alexlutsenko7/Nimbus_private/Book/Graphics/70ac2a42-c404-4ae4-8e17-2ef2ec8157f1.png

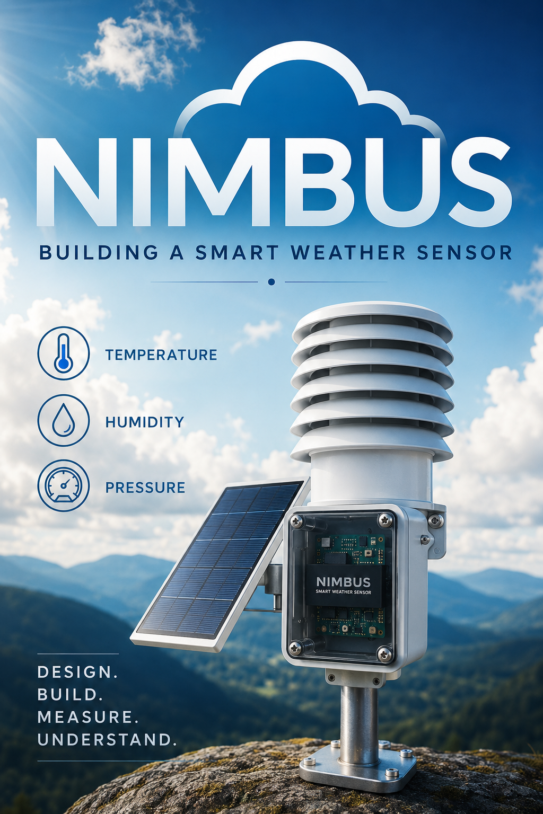
Book/Graphics/70ac2a42-c404-4ae4-8e17-2ef2ec8157f1.png
