alexlutsenko7/Nimbus_private/Book/Graphics/5ab63f9f-29ac-4de8-b75b-256e70acc06c.png

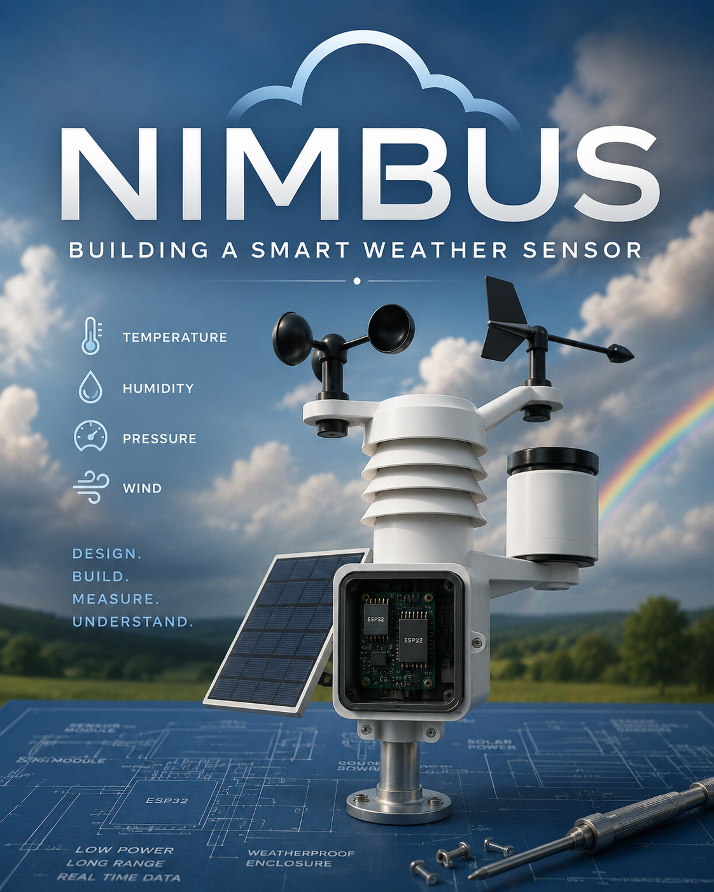
Book/Graphics/5ab63f9f-29ac-4de8-b75b-256e70acc06c.png
