alexlutsenko7/Nimbus_private/Book/Presentation_block_diagram.pptx

XIAO ESP32
Wi-Fi/BT

Antenna

BME280
Environment

Feedback

I2C

STM32L031
CPU eval board

USB to a PC

Pwr

UART

BME280
Environment

Pwr

I2C

STM32L031
CPU eval board

USB to a PC

Antenna

Bridge

BME280
Environment

Battery

Pwr

XIAO ESP32
Wi-Fi/BT

I2C

STM32L031
CPU eval board

Feedback

UART
