alexlutsenko7/Nimbus_private/android/ChangePass.jpg

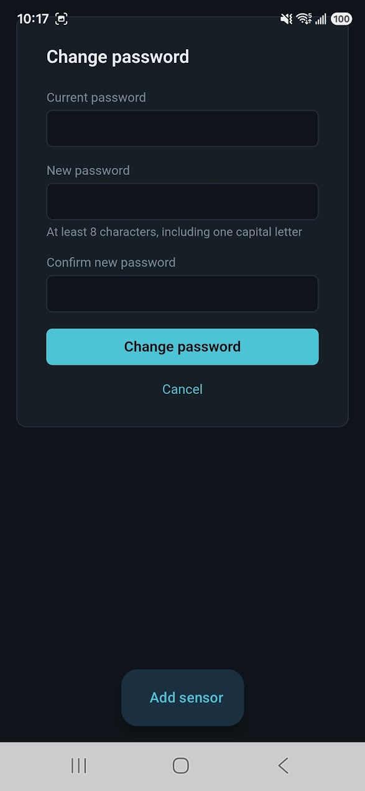
android/ChangePass.jpg
