alexlutsenko7/Nimbus_private/android/CreateAccount.jpg

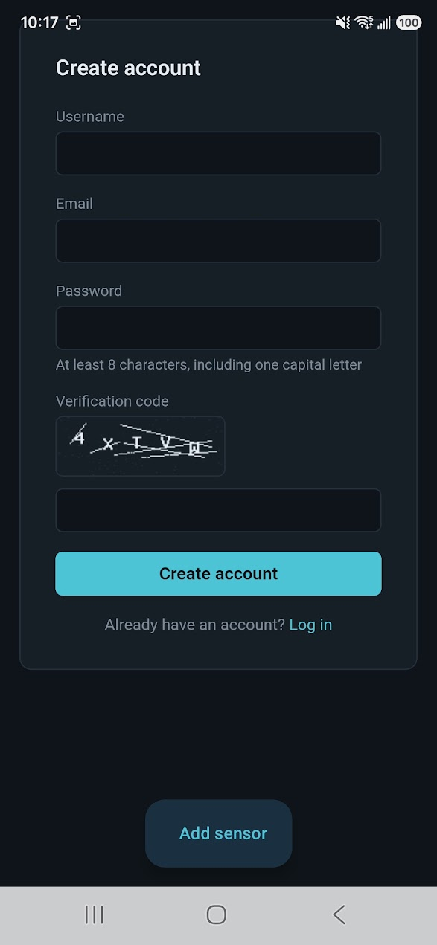
android/CreateAccount.jpg
