alexlutsenko7/Nimbus_private/android/Login.jpg

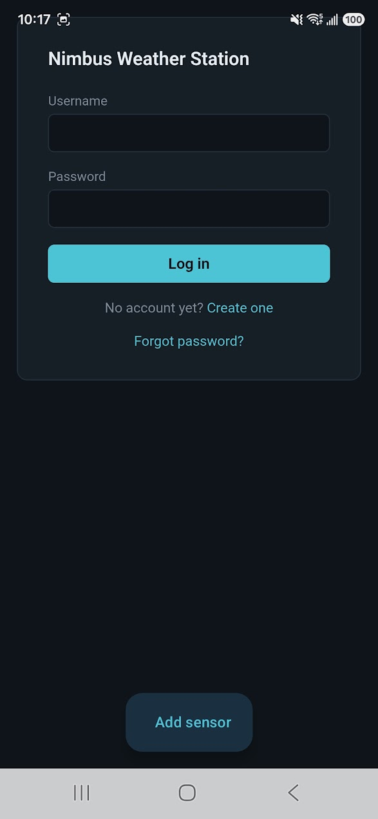
android/Login.jpg
