alexlutsenko7/Nimbus_private/android/MainScreeshot.jpg

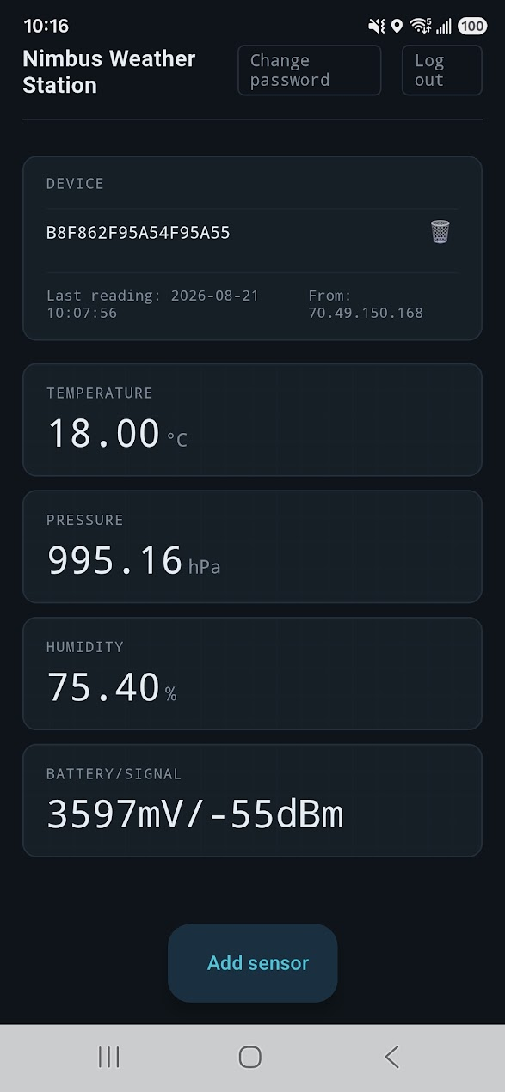
android/MainScreeshot.jpg
