alexlutsenko7/Nimbus_private/android/title_screen_pc.jpg

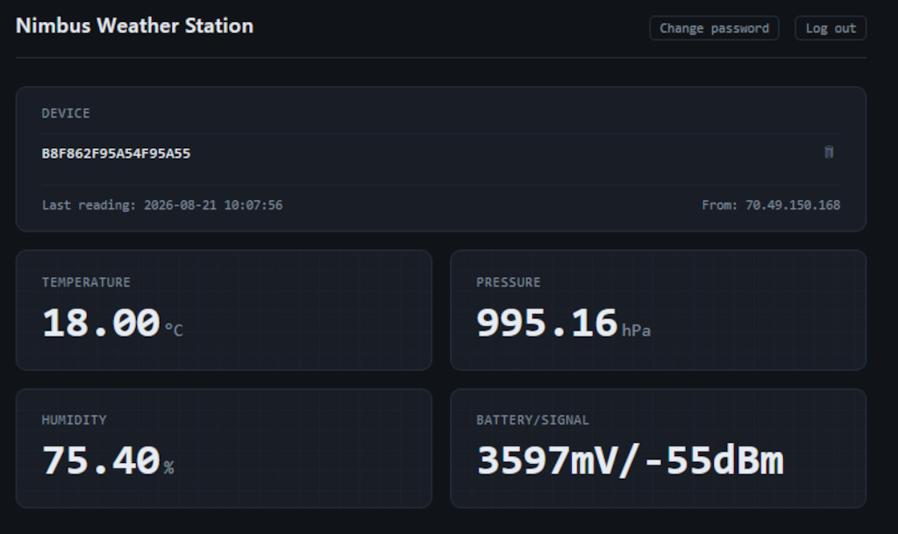
android/title_screen_pc.jpg
