alexlutsenko7/Nimbus_private/Sch_pcb/Nimbus-BOM_JLCSMT.xlsx

Comment | Designator | Footprint | JLCPCB Part #（optional）
100nF | C1, C2, C4, C5, C7, C9, C12 | C_0603_1608Metric | C1591
100uF | C6, C8, C11 | C_1206_3216Metric | C312983
22uF | C3 | C_0603_1608Metric | C84419
1000uF | C10 | CAP_10 | C43339
100k | R3, R4, R7 | R_0603_1608Metric | C14675
4k7 | R5, R6 | R_0603_1608Metric | C25999
470 | R1 | R_0603_1608Metric | C177286
1M | R2 | R_0603_1608Metric | C177344
Ferrite Bead 0805 | L1 | L_0805 | C85840
LED NCD0603R1 | D1 | D_0603_1608Metric | C84263
TPS22917DBV | U3 | SOT-23-6 | C2680344
STM32L031K6T6TR | U1 | LQFP-32(7x7) | C94085
BME280 | U2 | LGA-8(2.5x2.5) | C92489
AO3401A | Q1 | SOT-23 | C15127
