alexlutsenko7/Nimbus_private/Sch_pcb/Sample-BOM_JLCSMT.xlsx

Comment | Designator | Footprint | JLCPCB Part #（optional）
100uF | C1 | CAP-SMD_L3.5-W2.8 | C16133
15K | R5,R6 | R0603 | C22809
DC-005-20A_C136744 | DC1 | DC-IN-TH_DC-005-20A | C136744
Header-Female-2.54_1x8 | P2,P3 | HDR-TH_8P-P2.54-V | C27438
K2-1102DP-C4SW-04 | SW1 | KEY-TH_4P-L6.0-W6.0-P4.50-LS6.5 | C110153
ATMEGA328P-PU | U1 | DIP-28_L34.6-W7.3-P2.54-LS10.2-BL | C33901
670688000 | USB1 | USB-B-TH_67068-8000 | C114097
