alexlutsenko7/Nimbus_private/Book/Graphics/Pict1Nimbus_components.png

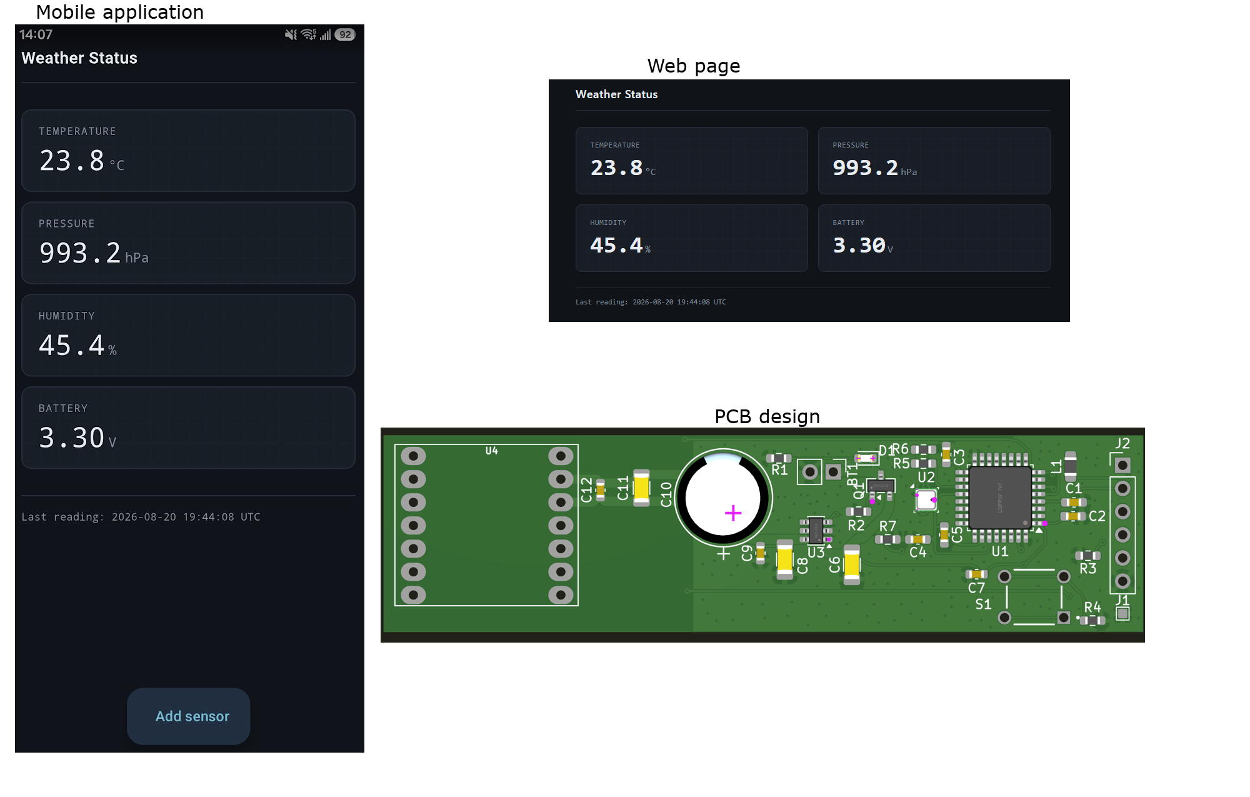
Book/Graphics/Pict1Nimbus_components.png
