alexlutsenko7/Nimbus_private/Sch_pcb/Nimbus.kicad_pcb

## KiCad design Sch_pcb/Nimbus.kicad_pcb (2026-08-18)

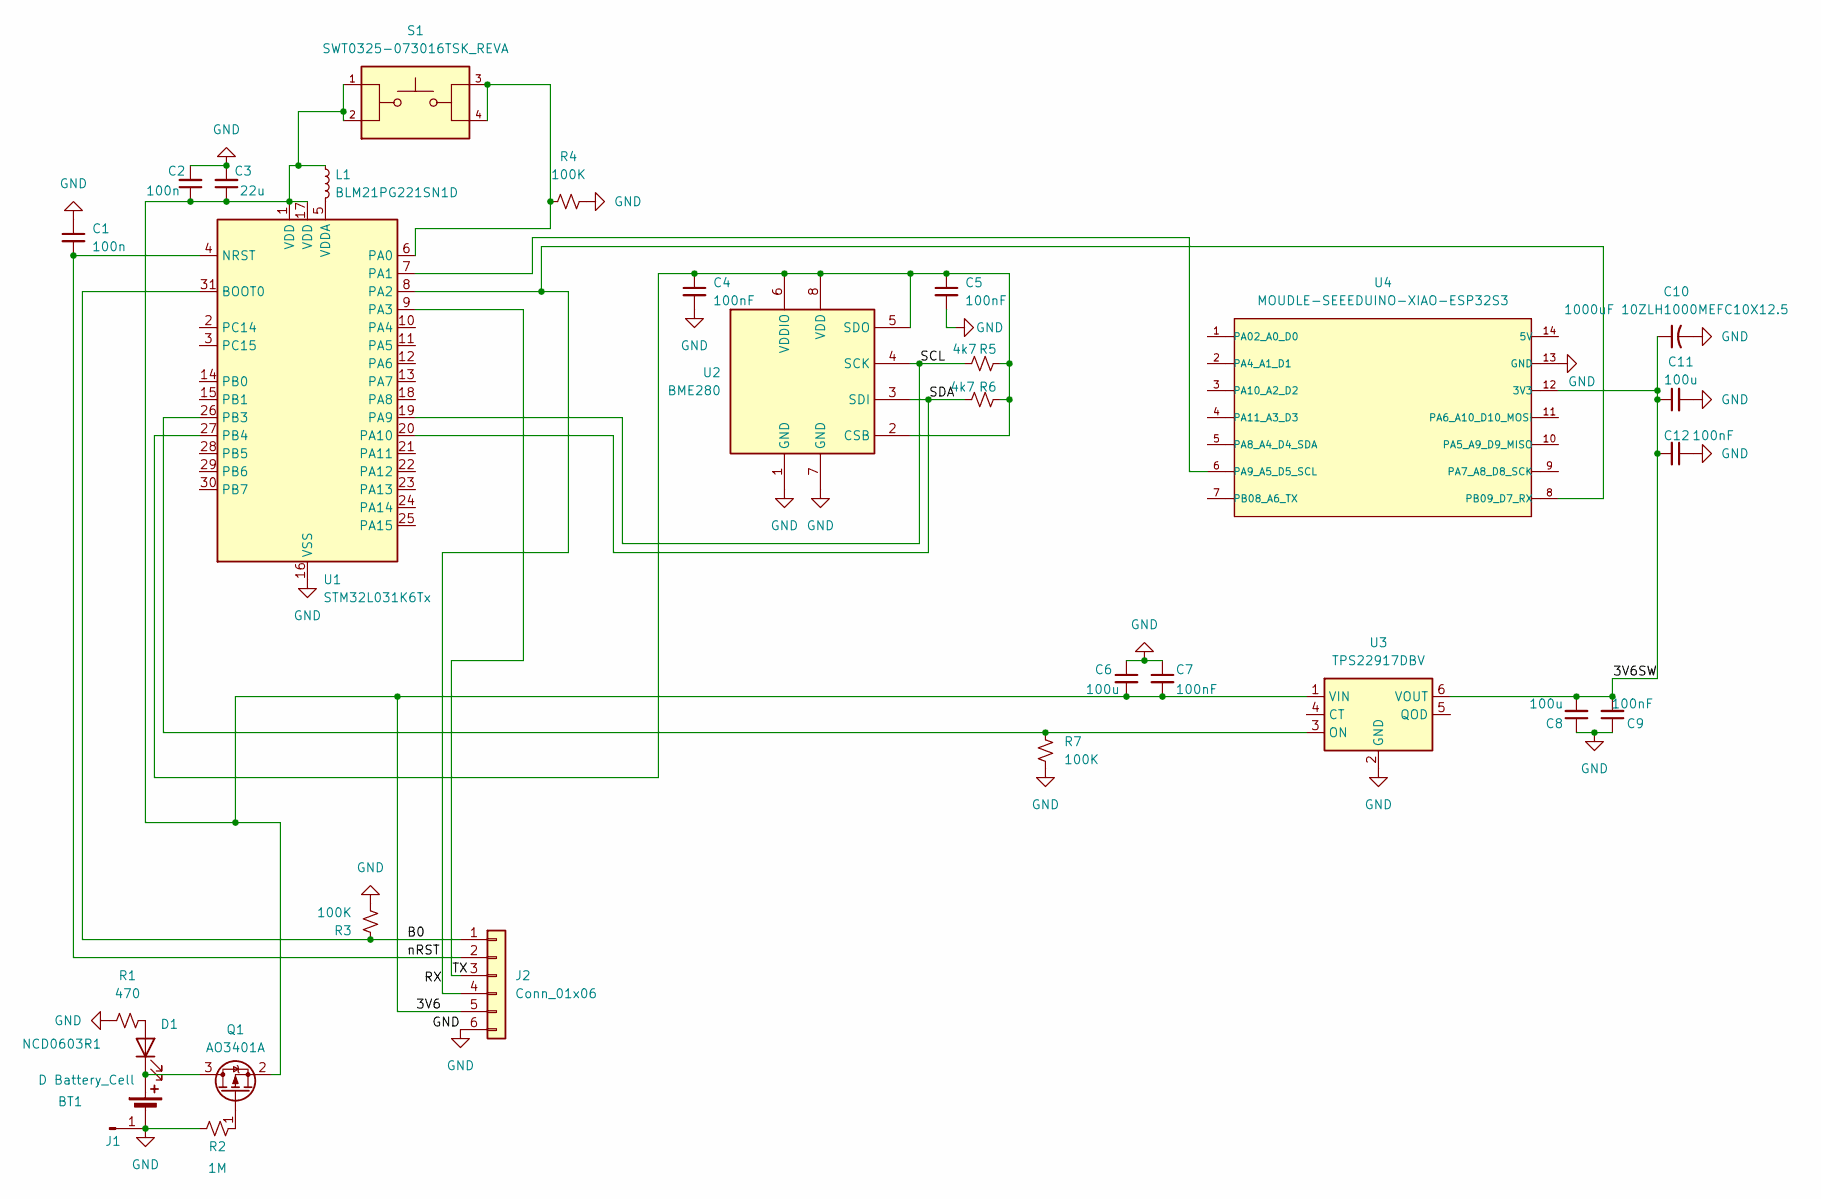
[picture p9: schematic Nimbus.kicad_sch]

Parts:
BT1: D Battery_Cell; PinHeader_1x02_P2.54mm_Vertical
C1, C2: 100n; C_0603_1608Metric_Pad1.08x0.95mm_HandSolder
C3: 22u; C_0603_1608Metric_Pad1.08x0.95mm_HandSolder
C4, C5: 100nF; C_0603_1608Metric_Pad1.08x0.95mm_HandSolder
C6, C8: 100u; C_1206_3216Metric_Pad1.33x1.80mm_HandSolder
C7, C9, C12: 100nF; C_0603_1608Metric
C10: 1000uF 10ZLH1000MEFC10X12.5; CAP_10X12.5_RUB
C11: 100u; C_1206_3216Metric
D1: NCD0603R1; D_0603_1608Metric
J1: GND; TestPoint_Pad_1.0x1.0mm
J2: Conn_01x06; PinHeader_1x06_P2.54mm_Vertical
L1: BLM21PG221SN1D; L_0805_2012Metric_Pad1.05x1.20mm_HandSolder
Q1: AO3401A; SOT-23
R1: 470; R_0603_1608Metric_Pad0.98x0.95mm_HandSolder
R2: 1M; R_0603_1608Metric_Pad0.98x0.95mm_HandSolder
R3, R4, R7: 100K; R_0603_1608Metric_Pad0.98x0.95mm_HandSolder
R5, R6: 4k7; R_0603_1608Metric_Pad0.98x0.95mm_HandSolder
S1: SWT0325-073016TSK_REVA; SW_SWT0325-073016TSK_REVA; PARTREV A
U1: STM32L031K6Tx; LQFP-32_7x7mm_P0.8mm
U2: BME280; Bosch_LGA-8_2.5x2.5mm_P0.65mm_ClockwisePinNumbering
U3: TPS22917DBV; SOT-23-6
U4: MOUDLE-SEEEDUINO-XIAO-ESP32S3; AlxXIAO_MOUDLE14P-SMD-2.54-21X17.8MM

Connections:
/3V6: C2.1, C3.1, C6.2, C7.2, J2.5, L1.1, Q1.2 (S), S1.1, S1.2, U1.1 (VDD), U1.17 (VDD), U3.1 (VIN)
/3V6SW: C8.2, C9.2, C10.1, C11.1, C12.2, U3.6 (VOUT), U4.12 (3V3)
/B0: J2.1, R3.1, U1.31 (BOOT0)
/RX: J2.4, U1.8 (PA2), U4.8 (PB09_D7_RX)
/SCL: R5.1, U1.19 (PA9), U2.4 (SCK)
/SDA: R6.1, U1.20 (PA10), U2.3 (SDI)
/TX: J2.3, U1.9 (PA3)
/nRST: C1.2, J2.2, U1.4 (NRST)
GND: BT1.2 (-), C1.1, C2.2, C3.2, C4.2, C5.2, C6.1, C7.1, C8.1, C9.1, C10.2, C11.2, C12.1, J1.1 (Pin_1_1), J2.6, R1.1, R2.1, R3.2, R4.2, R7.2, U1.16 (VSS), U1.32 (VSS), U2.1 (GND), U2.7 (GND), U3.2 (GND), U4.13 (GND)
unnamed: BT1.1 (+), D1.1 (K), Q1.3 (D)
unnamed: D1.2 (A), R1.2
unnamed: Q1.1 (G), R2.2
unnamed: R4.1, S1.3, S1.4, U1.6 (PA0)
unnamed: U1.7 (PA1), U4.6 (PA9_A5_D5_SCL)
unnamed: R7.1, U1.26 (PB3), U3.3 (ON)
unnamed: C4.1, C5.1, R5.2, R6.2, U1.27 (PB4), U2.2 (CSB), U2.5 (SDO), U2.6 (VDDIO), U2.8 (VDD)
unnamed: L1.2, U1.5 (VDDA)

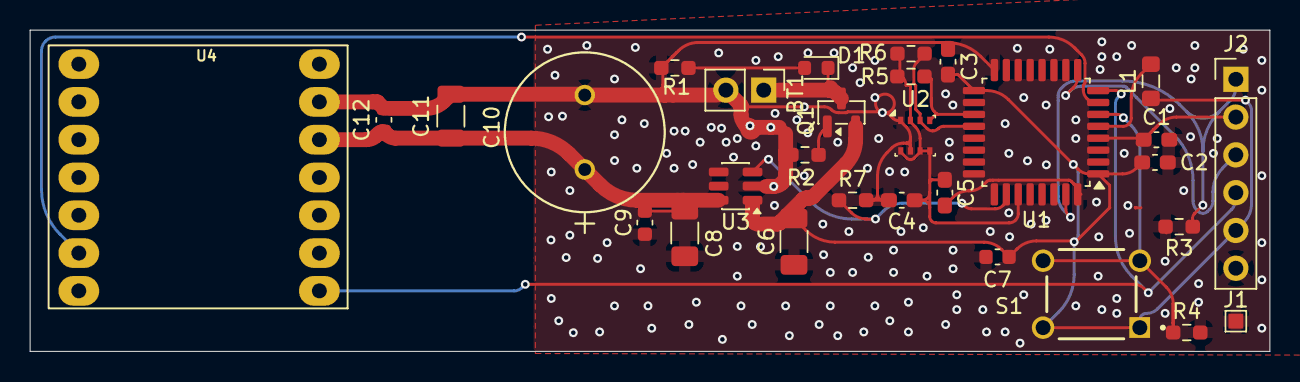
[picture p10: board Nimbus.kicad_pcb from above]

Board: 2 copper layers, 83.3 x 21.6 mm, 30 parts (0 on the bottom side), 17 nets.
