alexlutsenko7/Nimbus_private/STM32/Core/Inc/main.h

#define SetupButton_Pin GPIO_PIN_0
#define SetupButton_GPIO_Port GPIOA
#define ESP_FEEDBACK_Pin GPIO_PIN_1
#define ESP_FEEDBACK_GPIO_Port GPIOA
#define VCP_TX_Pin GPIO_PIN_2
#define VCP_TX_GPIO_Port GPIOA
#define TMS_Pin GPIO_PIN_13
#define TMS_GPIO_Port GPIOA
#define TCK_Pin GPIO_PIN_14
#define TCK_GPIO_Port GPIOA
#define VCP_RX_Pin GPIO_PIN_15
#define VCP_RX_GPIO_Port GPIOA
#define Power_WiFi_BT_Pin GPIO_PIN_3
#define Power_WiFi_BT_GPIO_Port GPIOB
#define SENSOR_PWR_Pin GPIO_PIN_4
#define SENSOR_PWR_GPIO_Port GPIOB
#define MID_BUFFER_SIZE			128
#define ESP_GENTIMEOUT			1000u
#define WIFI_NORMAL				30000u
#define SETUP_TIMEOUT			600000
#define VREFINT_CAL_ADDR    	((uint16_t *)0x1FF80078UL)
#define VREFINT_CAL_VREF_MV    	3000UL
#define ADC_TIMEOUT_MS          1000u
#define ADC_INVALID_RESULT      0u
#define DEBUG_MODE        0
#define IWDG_PRESCALER_ACTIVE   IWDG_PRESCALER_8
#define IWDG_PRESCALER_ACTIVE   IWDG_PRESCALER_32
#define IWDG_RELOAD_ACTIVE      4095u
#define IWDG_PRESCALER_SLEEP    IWDG_PRESCALER_8
#define IWDG_PRESCALER_SLEEP    IWDG_PRESCALER_128
#define IWDG_RELOAD_SLEEP       4095u
#define RETRY_INIT_CNT			5
#define INIT_DELAY				200
#define RESET_DELAY				20
#define LONG_RESET_BME280		500
#define CTRL_BME280				0x25
#define BME280_SLAVE			0x77
#define BME280_ID_VAL			0x60
#define BME280_REG_ID			0xD0
#define BME280_REG_DIG_T1      	0x88
#define BME280_REG_DIG_H1      	0xA1
#define BME280_REG_DIG_H2      	0xE1
#define BME280_REG_RESET       	0xE0
#define BME280_REG_CTRL_HUM    	0xF2
#define BME280_REG_STATUS      	0xF3
#define BME280_REG_CTRL_MEAS   	0xF4
#define BME280_REG_CONFIG      	0xF5
#define BME280_REG_DATA_START  	0xF7
#define BME280_REG_VALUE_RST	0xB6
#define DEFAULT_TIMEOUT			0xFFFF
#define TIMEOUT_MASK			0xF
#define TIMEOUT_MASK			0x3F
#define HAL_BUTTON_TIMEOUT		500
