alexlutsenko7/Nimbus_private/(commit log)

2026-08-11 STM32 code
2026-08-11 Web version updated
    [log_2026.csv]
2026-08-11 Changed everything to a db, no file operation and added verified/alxlabs made device list population
2026-08-12 Production modifications: 1. Email verification at account create has been added 2. Forgot password has been added 3. Some layout was changed related to fresh configuration when no sensor is availabl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
2026-08-12 1. Changed time displayed in the main window to match the timezones 2. Worked on stability of wifi detection/access
    [main.c, wifi_bt.ino]
2026-08-13 Improved stability, added connection to the stongest AP available thruout given WiFi network
    [wifi_bt.ino]
2026-08-13 All the debug prints are routed to external UART pin to collect more data in real life conditions
2026-08-13 Improved handling for failing a wifi network if connection was OK but DNS lookup failed
    [wifi_bt.ino]
2026-08-13 The one real bug, found in the process: the ESP32's own debug log line (wifi_bt.ino:1219, in parse_measurement()) split the temperature into integer and fractional parts for display, and for any valu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
    [wifi_bt.ino]
2026-08-14 1. Android App improvemement, added "No internet connection" as well as "Loading..." for slow connections 2. Added mutiple sensors handled under 1 account. As soon as new device has been added, an ol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
2026-08-18 Schematics and PCB were added
    [Nimbus-BOM_JLCSMT.xlsx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]
2026-08-19 Added printf over standard USB of the string like 0xc0bec0b0b01cdbd45a80345a8035 which contains the beacon, 0xc0bec0b0b0 + device id. This supposed to be taken during production and put into the devi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
2026-08-19 Added CPP production s/w to update the devices table of the databse based on the board output if pin0 is grounded
2026-08-20 Added multiple devices on the main page for the supplied application
2026-08-20 If device exists then it will become registered to uid=0 if this script is called
